nthuee822/project_meatball/images/1769949203630.jpg

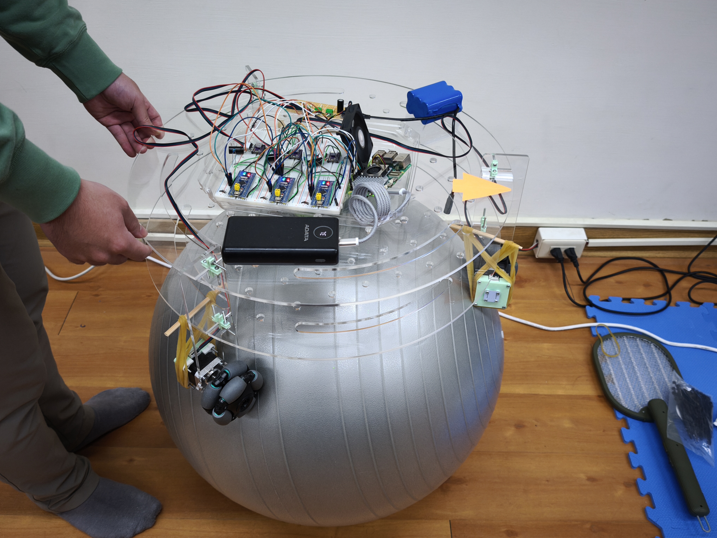
images/1769949203630.jpg
