nthuee822/project_meatball/images/154278.jpg

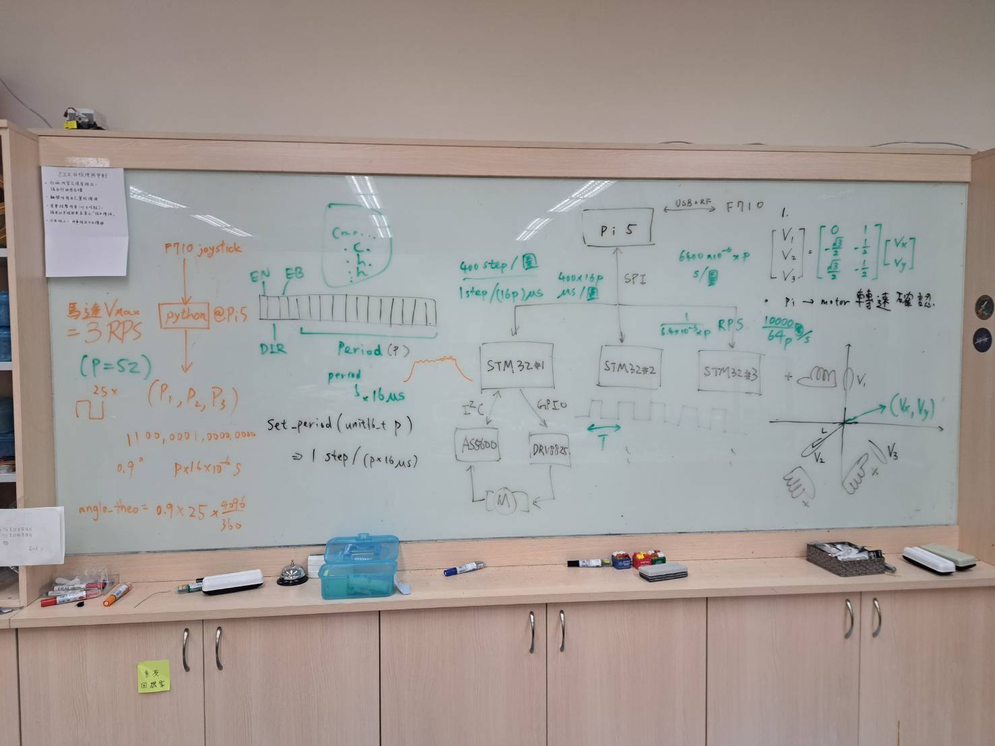
images/154278.jpg
