nthuee822/project_meatball/images/Gemini_Generated_Image_a7wogra7wogra7wo.png

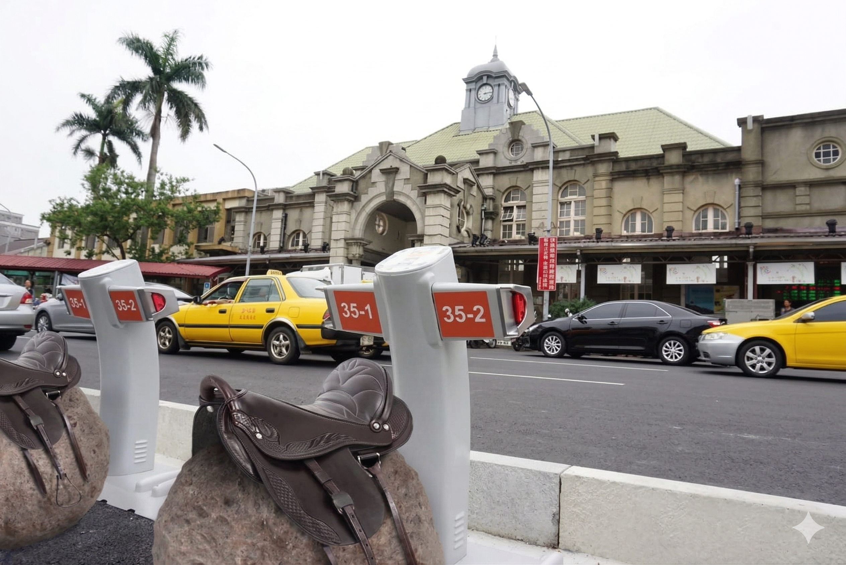
images/Gemini_Generated_Image_a7wogra7wogra7wo.png
