nthuee822/project_meatball/hardware/ht7k1401_breakout/production/bom.csv

Designator | Footprint | Quantity | Value | LCSC Part #
C1, C3, C4 | 0805 | 3 | 100n
C2 | CP_Radial_D6.3mm_P2.50mm | 1 | 100u
J1, J2 | TerminalBlock_MaiXu_MX126-5.0-02P_1x02_P5.00mm | 2 | Conn_01x02_Socket
J3 | PinHeader_1x05_P2.54mm_Vertical | 1 | Conn_01x05_Pin
R1 | 2512_shunt | 1 | 200m
R2, R3 | 0805 | 2 | 10k
R4, R5, R6, R7 | 0805 | 4 | 30k
TP1, TP2 | TestPoint_THTPad_D1.5mm_Drill0.7mm | 2 | TestPoint
U1 | HSOP-8-1EP_3.9x4.9mm_P1.27mm_EP2.41x3.1mm | 1 | HT7K1401
U2 | SOIC-8_3.9x4.9mm_P1.27mm | 1 | OPAMP
