nthuee822/project_meatball/3d_model/magnet_mold-Body.3mf

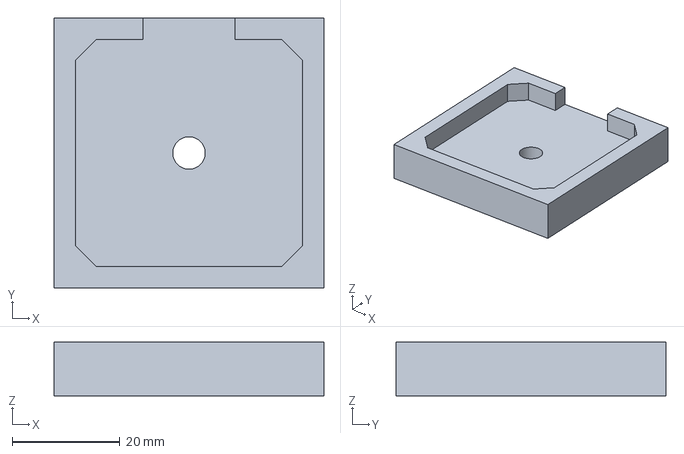
[picture p4: CAD file, 2026-07-13]
3d_model/magnet_mold-Body.3mf
50.0 x 50.0 x 10.0 mm
