nthuee822/project_meatball/3d_model/motor_holder-Body.3mf

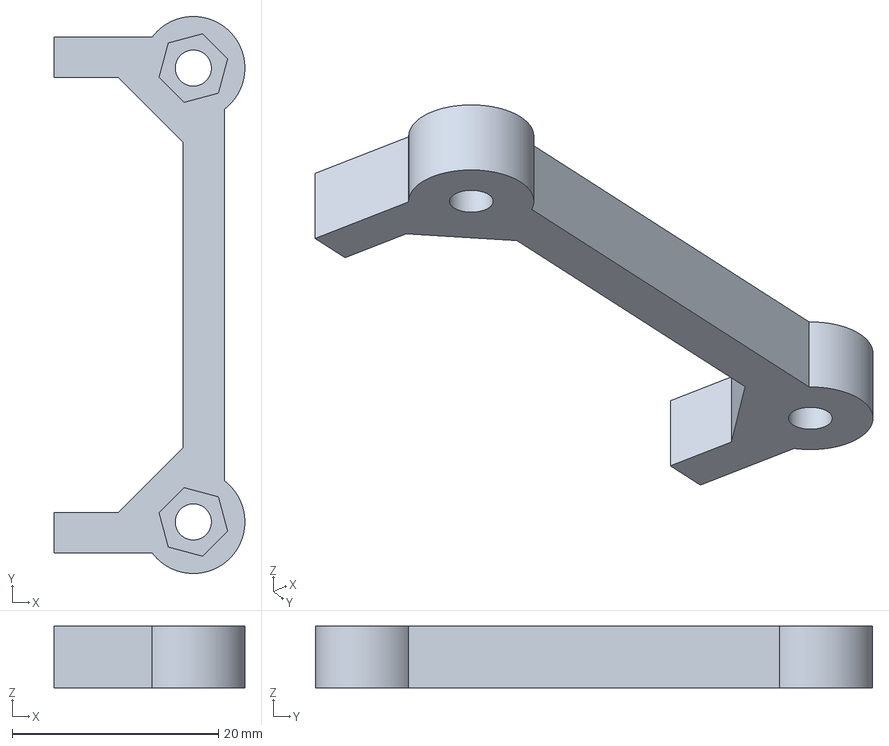
[picture p5: CAD file, 2026-07-13]
3d_model/motor_holder-Body.3mf
18.5 x 54.0 x 6.00 mm
