nthuee822/project_meatball/3d_model/hall_sensor_holder_v2-Body.3mf

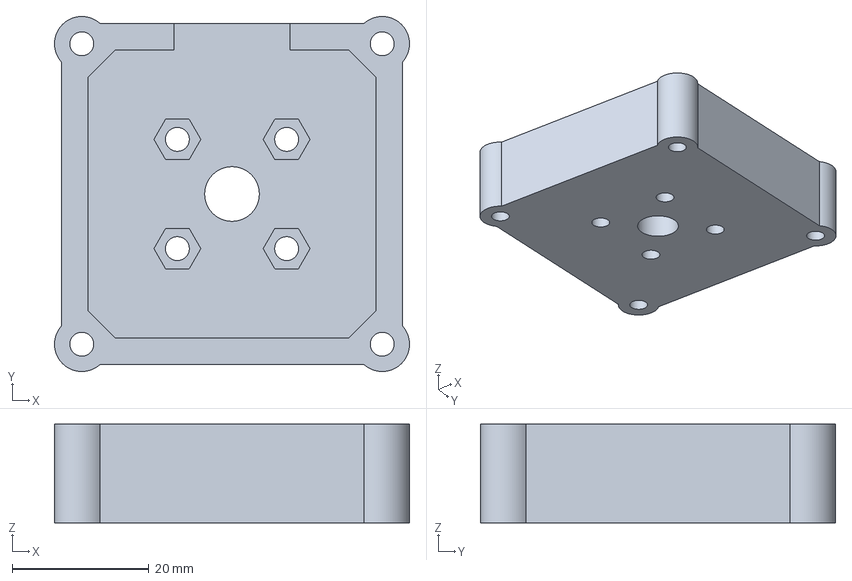
[picture p6: CAD file, 2026-07-13]
3d_model/hall_sensor_holder_v2-Body.3mf
52.0 x 52.0 x 14.5 mm
