nthuee822/project_meatball/3d_model/corner-Body.3mf

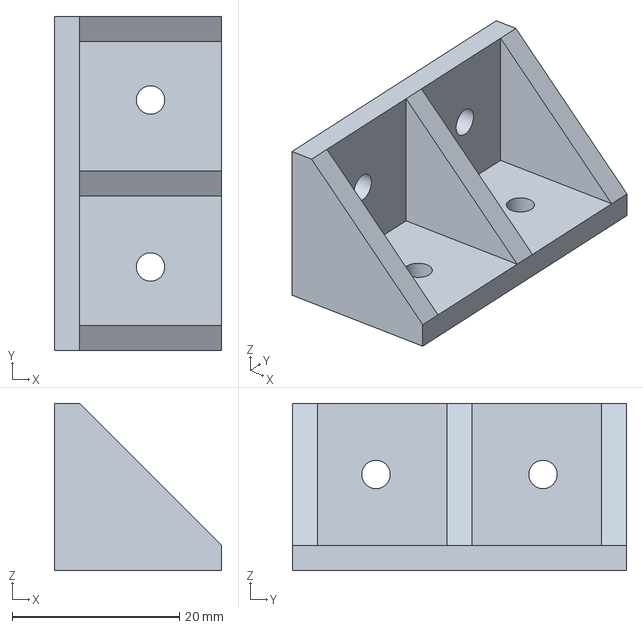
[picture p7: CAD file, 2026-07-13]
3d_model/corner-Body.3mf
20.0 x 40.0 x 20.0 mm
