nthuee822/project_meatball/3d_model/hall_sensor_holder.FCStd

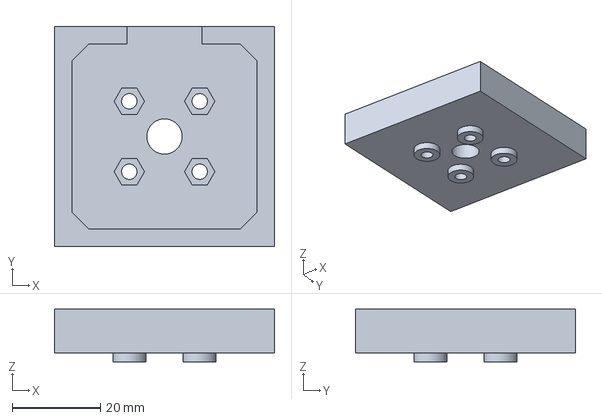
[picture p8: CAD file, 2026-07-13]
3d_model/hall_sensor_holder.FCStd
50.0 x 50.0 x 12.0 mm
