nthuee822/project_meatball/3d_model/hall_sensor_washer-Body.3mf

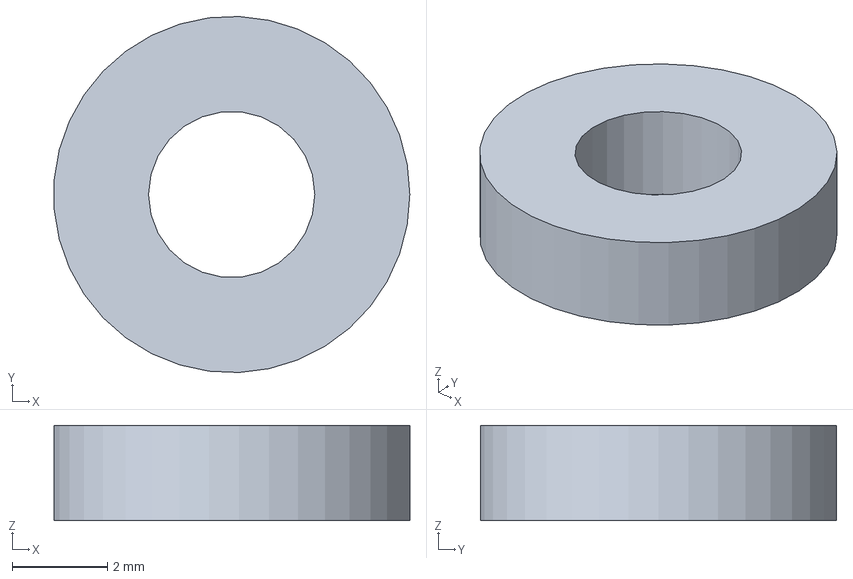
[picture p9: CAD file, 2026-07-13]
3d_model/hall_sensor_washer-Body.3mf
7.49 x 7.49 x 2.00 mm
