nthuee822/project_meatball/(list of files, cad)

Other CAD files:
3d_model/magnet_mold.FCStd
3d_model/motor_holder.FCStd
3d_model/hall_sensor_holder_v2.FCStd
3d_model/corner.FCStd
3d_model/hall_sensor_holder-Body.3mf
3d_model/magnet_mold-Body-55.3mf
3d_model/hall_sensor_washer.FCStd
