nthuee822/project_meatball/stm32/adc_alignment_test/default.csv

Time (s) | Channel 1 (V) | Channel 2 (V)
0.1490640601173546 | 3.328230990314466 | 2.371660884159364
0.1490641901173546 | 3.329122501781653 | 2.375237606756229
0.1490643201173546 | 3.326447967379739 | 2.376131787405312
0.1490644501173546 | 3.323773432977882 | 2.380602690651547
0.1490645801173546 | 3.327339478847092 | 2.384179413247884
0.1490647101173546 | 3.324664944445176 | 2.388650316493303
0.1490648401173546 | 3.326447967379747 | 2.381496871300358
0.1490649701173546 | 3.329122501781663 | 2.381496871300358
0.1490651001173546 | 3.325556455912392 | 2.385073593897048
0.1490652301173546 | 3.328230990314308 | 2.385073593897048
0.1490653601173546 | 3.330014013249154 | 2.3752376067564
0.1490654901173546 | 3.32733947884724 | 2.380602690650898
0.1490656201173546 | 3.330014013248898 | 2.382391051949313
0.1490657501173546 | 3.32377343297776 | 2.378814329352978
0.1490658801173546 | 3.325556455912847 | 2.384179413248078
0.1490660101173546 | 3.332688547651291 | 2.38686195519533
0.1490661401173546 | 3.318424364173881 | 2.378814329353002
0.1490662701173546 | 3.32644796737963 | 2.380602690651169
0.1490664001173546 | 3.327339478846815 | 2.383285232598137
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
