nthuee822/project_meatball/stm32/adc_alignment_test/adc_plot.png

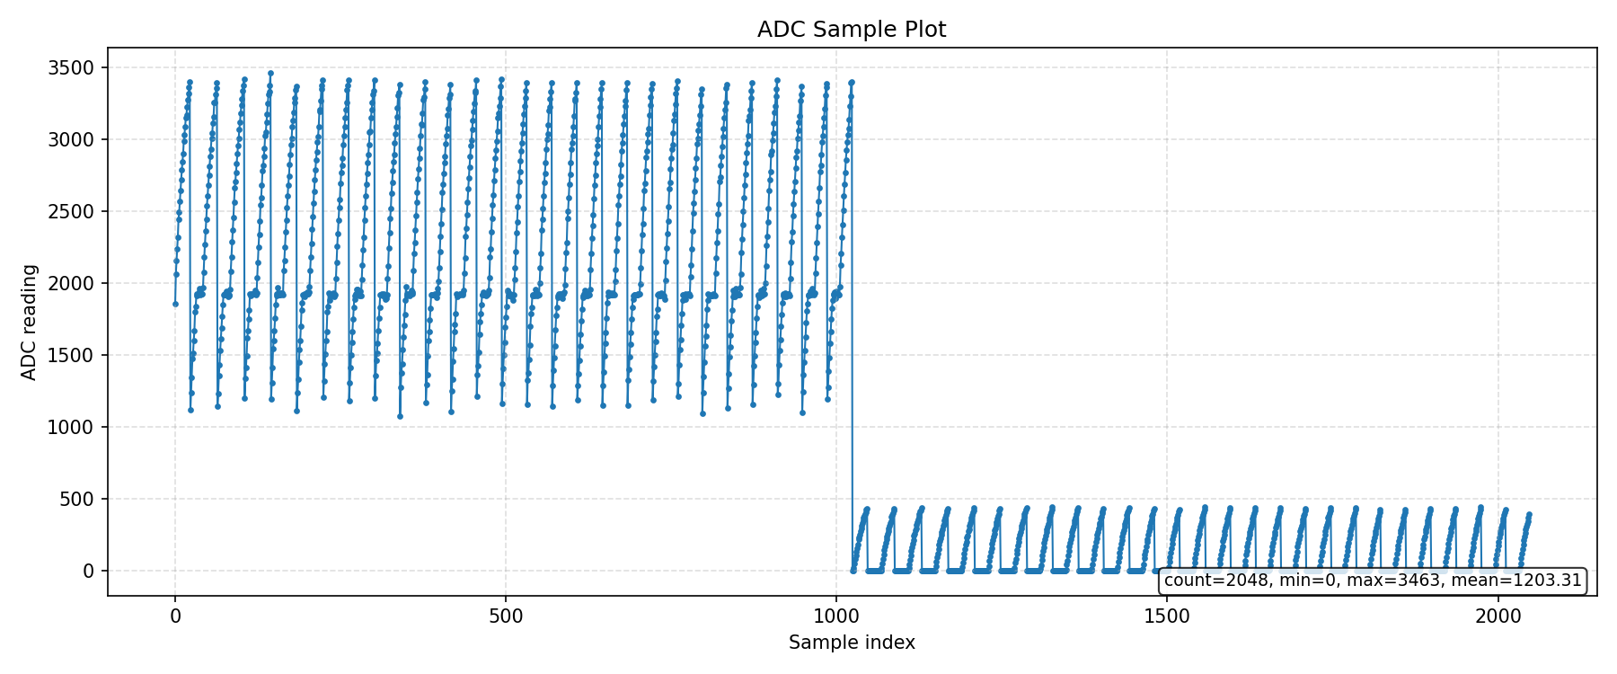
stm32/adc_alignment_test/adc_plot.png
