nthuee822/project_meatball/stm32/adc_alignment_test/adc_plot_original.png

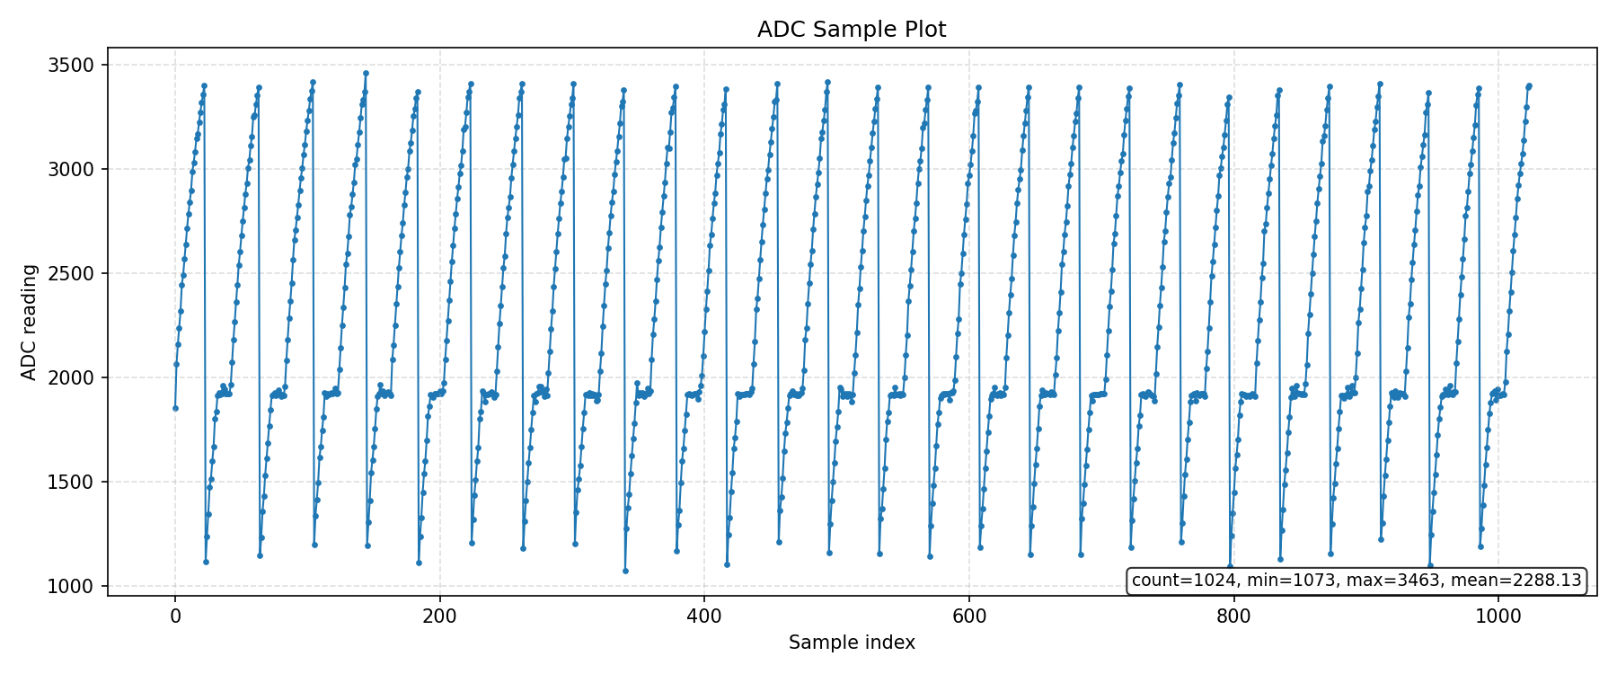
stm32/adc_alignment_test/adc_plot_original.png
