nthuee822/project_meatball/architecture/architecture.pdf

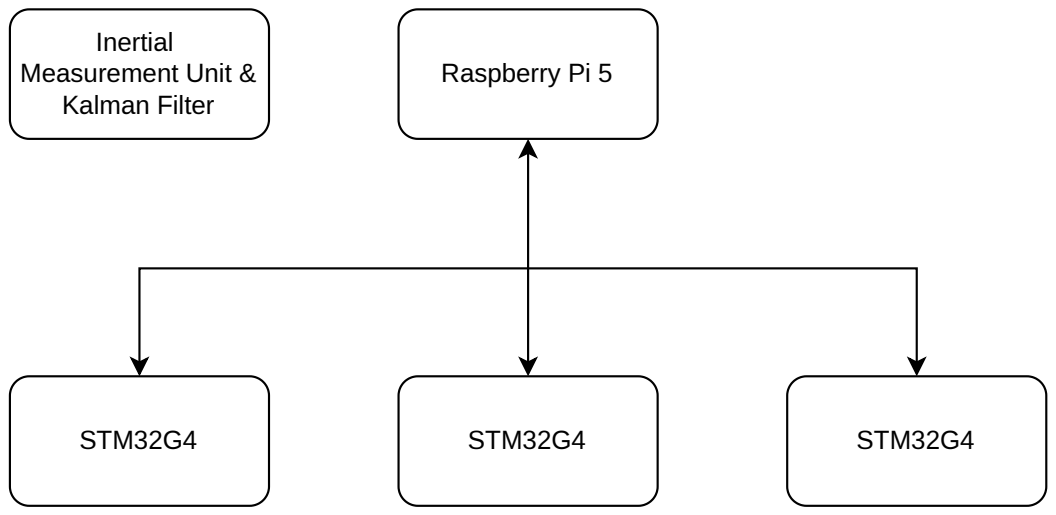
[picture p12: page 1]
Raspberry Pi 5; STM32G4; Inertial Measurement Unit & Kalman Filter
