nthuee822/project_meatball/architecture/architecture_v1.pdf

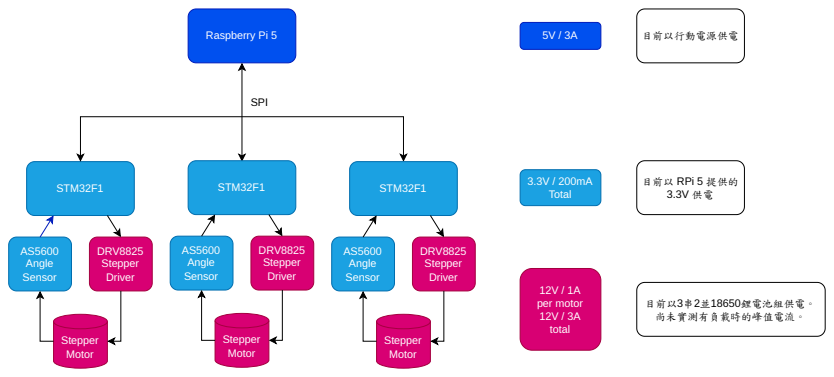
[picture p13: page 1]
Raspberry Pi 5; STM32F1; DRV8825 Stepper Driver; AS5600 Angle Sensor; Stepper Motor; SPI; 3.3V / 200mA Total; 12V / 1A per motor 12V / 3A total; 目前以行動電源供電; 目前以3串2並18650鋰電池組供電。 尚未實測有負載時的峰值電流。

目前以 RPi 5 提供的
