nthuee822/project_meatball/hardware/ht7k1401_breakout/ht7k1401_breakout.pdf

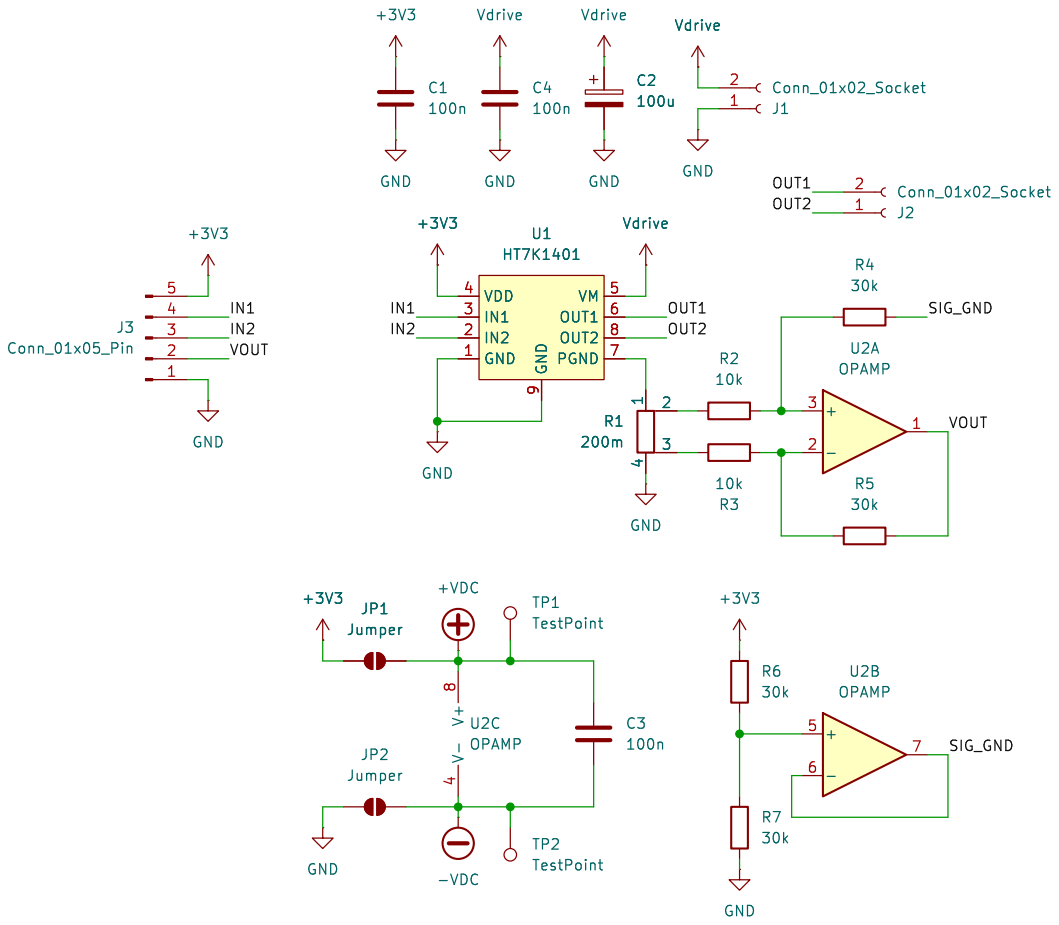
[picture p14: page 1]

9 VM 5 OUT1 6 OUT2 8 PGND 7 U1 HT7K1401 Vdrive Vdrive C2

Id: 1/1 Title: File: ht7k1401_breakout.kicad_sch Sheet: /
