nthuee822/project_meatball/hardware/ht7k1401_breakout/ht7k1401_breakout.kicad_pcb

## KiCad design hardware/ht7k1401_breakout/ht7k1401_breakout.kicad_pcb (2026-07-13)

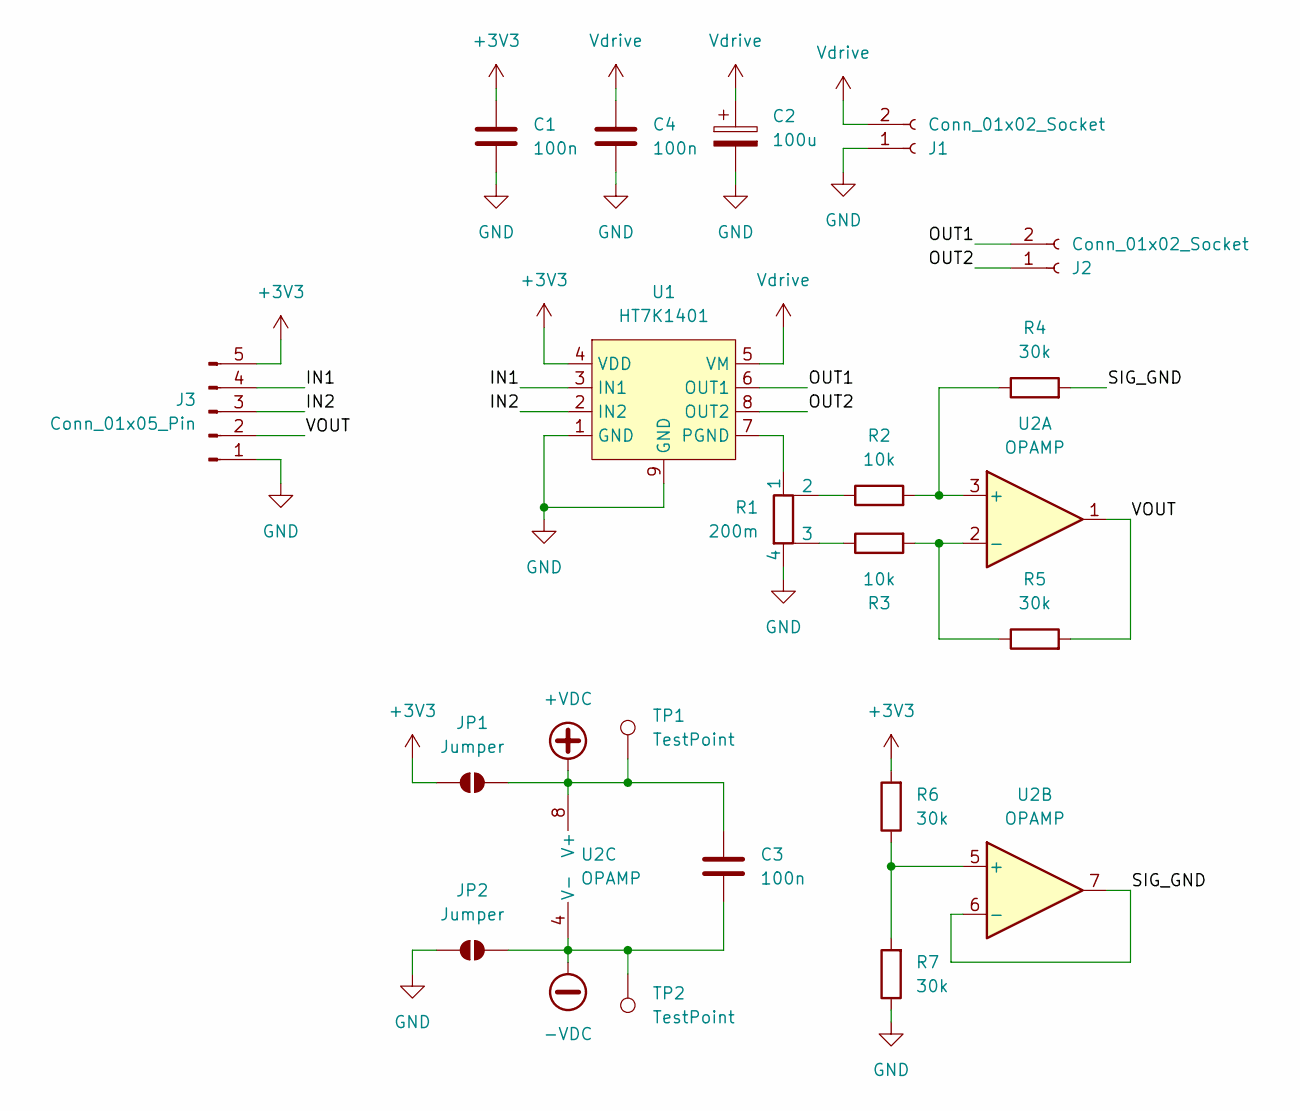
[picture p15: schematic ht7k1401_breakout.kicad_sch]

Parts:
C1, C3, C4: 100n; C_0805_2012Metric_Pad1.18x1.45mm_HandSolder
C2: 100u; CP_Radial_D6.3mm_P2.50mm
J1, J2: Conn_01x02_Socket; TerminalBlock_MaiXu_MX126-5.0-02P_1x02_P5.00mm
J3: Conn_01x05_Pin; PinHeader_1x05_P2.54mm_Vertical
JP1, JP2: Jumper; SolderJumper-2_P1.3mm_Open_RoundedPad1.0x1.5mm
R1: 200m; 2512_shunt
R2, R3: 10k; R_0805_2012Metric_Pad1.20x1.40mm_HandSolder
R4, R5, R6, R7: 30k; R_0805_2012Metric_Pad1.20x1.40mm_HandSolder
TP1, TP2: TestPoint; TestPoint_THTPad_D1.5mm_Drill0.7mm
U1: HT7K1401; HSOP-8-1EP_3.9x4.9mm_P1.27mm_EP2.41x3.1mm
U2: OPAMP; SOIC-8_3.9x4.9mm_P1.27mm

Connections:
+3V3: C1.1, J3.5, JP1.1 (A), R6.2, U1.4 (VDD)
+VDC: C3.1, JP1.2 (B), TP1.1, U2.8 (V+)
-VDC: C3.2, JP2.2 (B), TP2.1, U2.4 (V-)
/IN1: J3.4, U1.3 (IN1)
/IN2: J3.3, U1.2 (IN2)
/OUT1: J2.2, U1.6 (OUT1)
/OUT2: J2.1, U1.8 (OUT2)
/SIG_GND: R4.2, U2.6 (-), U2.7
/VOUT: J3.2, R5.2, U2.1
GND: C1.2, C2.2, C4.2, J1.1, J3.1, JP2.1 (A), R1.4, R7.1, U1.1 (GND), U1.9 (GND)
unnamed: R1.2, R2.1
unnamed: R1.3, R3.1
unnamed: R1.1, U1.7 (PGND)
unnamed: R2.2, R4.1, U2.3 (+)
unnamed: R3.2, R5.1, U2.2 (-)
unnamed: R6.1, R7.2, U2.5 (+)
Vdrive: C2.1, C4.1, J1.2, U1.5 (VM)

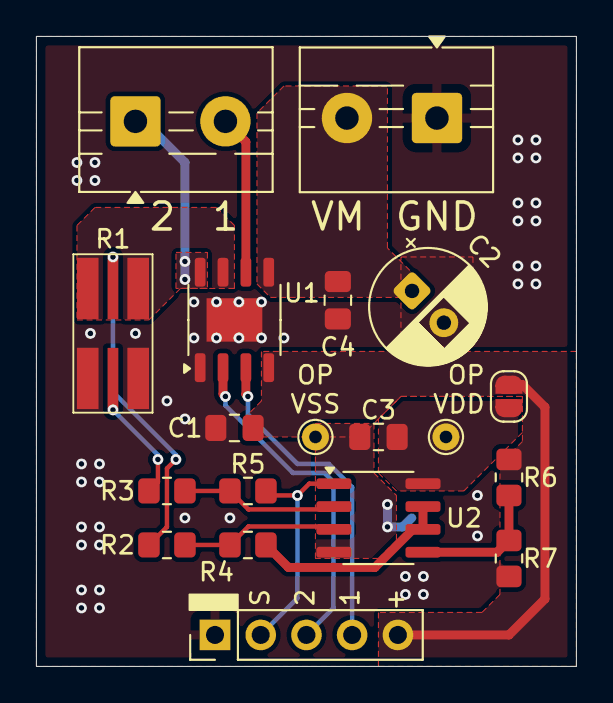
[picture p16: board ht7k1401_breakout.kicad_pcb from above]

Board: 2 copper layers, 30.0 x 35.0 mm, 20 parts (1 on the bottom side), 17 nets.
