nthuee822/project_meatball/stm32/foc_v1/Core/Src/main.c

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
/* Includes ------------------------------------------------------------------*/
#include "main.h"

/* USER CODE BEGIN Includes */
#include "as5600.h"
#include "kalman.h"
#include "stm32g4xx_hal_exti.h"
#include "stm32g4xx_hal_gpio.h"
#include "stm32g4xx_hal_tim.h"
#include <stdint.h>
#include "stm32-cordic.h"
/* USER CODE END Includes */

ADC_HandleTypeDef hadc1;
ADC_HandleTypeDef hadc2;

CORDIC_HandleTypeDef hcordic;

I2C_HandleTypeDef hi2c2;
DMA_HandleTypeDef hdma_i2c2_rx;

TIM_HandleTypeDef htim1;
TIM_HandleTypeDef htim6;
TIM_HandleTypeDef htim7;

UART_HandleTypeDef huart2;

/* USER CODE BEGIN PV */
AS5600_TypeDef *myAS5600;

volatile uint8_t timer_triggered = 0;
volatile uint8_t step_triggered = 0;
volatile uint8_t motor_enable = 0;
volatile uint8_t dma_ready = 0;

KalmanStruct KF;
KalmanStruct *kf;

uint16_t pwm_level[4][2] = {
  {75, 50},
  {50, 75},
  {25, 50},
  {50, 25}
};
/* USER CODE END PV */

void SystemClock_Config(void);
static void MX_GPIO_Init(void);
static void MX_DMA_Init(void);
static void MX_I2C2_Init(void);
static void MX_USART2_UART_Init(void);
static void MX_CORDIC_Init(void);
static void MX_TIM7_Init(void);
static void MX_TIM6_Init(void);
static void MX_TIM1_Init(void);
static void MX_ADC1_Init(void);
static void MX_ADC2_Init(void);
/**
  * @brief  The application entry point.
  * @retval int
  */
int main(void)
{

  /* MCU Configuration--------------------------------------------------------*/

  /* Reset of all peripherals, Initializes the Flash interface and the Systick. */
  HAL_Init();

  /* Configure the system clock */
  SystemClock_Config();

  /* Initialize all configured peripherals */
  MX_GPIO_Init();
  MX_DMA_Init();
  MX_I2C2_Init();
  MX_USART2_UART_Init();
  MX_CORDIC_Init();
  MX_TIM7_Init();
  MX_TIM6_Init();
  MX_TIM1_Init();
  MX_ADC1_Init();
  MX_ADC2_Init();
  /* USER CODE BEGIN 2 */
  // AS5600 setup
  myAS5600 = AS5600_New();
  myAS5600->i2cAddr = (0x36 << 1);  // 7-bit address shifted for HAL
  myAS5600->i2cHandle = &hi2c2;
  myAS5600->SlowFilter = AS5600_SLOW_FILTER_2X;
  myAS5600->FastFilterThreshold = AS5600_FAST_FILTER_6LSB;
  AS5600_Init(myAS5600);

  // Kalman filter setup
  kf = &KF;
  kf->dt = 50e-6f;
  kf->x[0] = 0.f;
  kf->x[1] = 0.f;
  kf->P[0][0] = 10.f;
  kf->P[0][1] = 0.f;
  kf->P[1][0] = 0.f;
  kf->P[1][1] = 10.f;
  kf->Q[0][0] = 0.01f;
  kf->Q[0][1] = 0.f;
  kf->Q[1][0] = 0.f;
  kf->Q[1][1] = 1e5f;
  kf->R = 0.24f;

  // timer setup
  HAL_TIM_Base_Start_IT(&htim6);
  HAL_TIM_Base_Start_IT(&htim7);
  /* USER CODE END 2 */

  /* Infinite loop */
  /* USER CODE BEGIN WHILE */
  int level_index = 0;
  while (1)
  {
    /* USER CODE END WHILE */

    /* USER CODE BEGIN 3 */
    if(step_triggered) {
      if(level_index >= 3) {
        level_index = 0;
      } else {
        level_index++;
      }

      step_triggered = 0;   // clear flag
    }

    if(timer_triggered) {
      if(motor_enable) {
        HAL_TIM_PWM_Start(&htim1, TIM_CHANNEL_2);
        HAL_TIMEx_PWMN_Start(&htim1, TIM_CHANNEL_2);
        HAL_TIM_PWM_Start(&htim1, TIM_CHANNEL_3);
        HAL_TIMEx_PWMN_Start(&htim1, TIM_CHANNEL_3);

        __HAL_TIM_SET_COMPARE(&htim1, TIM_CHANNEL_2, pwm_level[level_index][0]);  // A
        __HAL_TIM_SET_COMPARE(&htim1, TIM_CHANNEL_3, pwm_level[level_index][1]);  // B
      } else {
        HAL_TIM_PWM_Stop(&htim1, TIM_CHANNEL_2);
        HAL_TIMEx_PWMN_Stop(&htim1, TIM_CHANNEL_2);
        HAL_TIM_PWM_Stop(&htim1, TIM_CHANNEL_3);
        HAL_TIMEx_PWMN_Stop(&htim1, TIM_CHANNEL_3);
      }

      timer_triggered = 0;    // clear flag
    }
  }
  /* USER CODE END 3 */
}

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
/* USER CODE BEGIN 4 */
void HAL_TIM_PeriodElapsedCallback(TIM_HandleTypeDef *htim) {
  if(htim == &htim7) {
    timer_triggered = 1;
  }

  if (htim == &htim6) {
    step_triggered = 1;
  }
}

void HAL_GPIO_EXTI_Callback(uint16_t GPIO_Pin) {
  if(GPIO_Pin == GPIO_PIN_13) {
    motor_enable = !motor_enable;
  }
}
/* USER CODE END 4 */
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
