nthuee822/project_meatball/stm32/foc_v1/foc_v1.ioc

Mcu.UserName=STM32G431RBTx
PA0.Signal=ADC1_IN1
PA1.Signal=ADC2_IN2
PA13.GPIO_Label=T_SWDIO
PA13.Signal=SYS_JTMS-SWDIO
PA14.GPIO_Label=T_SWCLK
PA14.Signal=SYS_JTCK-SWCLK
PA2.Signal=USART2_TX
PA3.Signal=USART2_RX
PA8.Signal=I2C2_SDA
PA9.Signal=I2C2_SCL
PB0.Signal=TIM1_CH2N
PB1.Signal=TIM1_CH3N
PC1.Signal=S_TIM1_CH2
PC13.Signal=GPXTI13
PC2.Signal=S_TIM1_CH3
PF0-OSC_IN.GPIO_Label=RCC_OSC_IN
PF0-OSC_IN.Signal=RCC_OSC_IN
PF1-OSC_OUT.GPIO_Label=RCC_OSC_OUT
PF1-OSC_OUT.Signal=RCC_OSC_OUT
