nthuee822/project_meatball/stm32/motor/Core/Src/main.c

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
/* Includes ------------------------------------------------------------------*/
#include "main.h"

/* USER CODE BEGIN Includes */
#include "stm32_hal_legacy.h"
#include "stm32f103xb.h"
#include "stm32f1xx_hal_tim.h"
#include "stm32f1xx_hal.h"
#include "stm32f1xx_hal_def.h"
#include "stm32f1xx_hal_gpio.h"
#include "stdlib.h"
#include "as5600.h"
/* USER CODE END Includes */

/* USER CODE BEGIN PD */
#define DRV8825_1_STEP 0x00
#define DRV8825_2_STEP 0x01
#define DRV8825_4_STEP 0x02
#define DRV8825_8_STEP 0x03
#define DRV8825_16_STEP 0x04
#define DRV8825_32_STEP 0x05

#define MIN_PERIOD 64 // Minimum period for the step signal
/* USER CODE END PD */

I2C_HandleTypeDef hi2c1;

SPI_HandleTypeDef hspi1;

TIM_HandleTypeDef htim3;

UART_HandleTypeDef huart2;

void SystemClock_Config(void);
static void MX_GPIO_Init(void);
static void MX_I2C1_Init(void);
static void MX_SPI1_Init(void);
static void MX_TIM3_Init(void);
static void MX_USART2_UART_Init(void);
/* USER CODE BEGIN 0 */
void set_period(uint16_t period) {  // Sets the period for the step signal
  // TIM_OC_InitTypeDef sConfigOC;

  // sConfigOC.OCMode = TIM_OCMODE_TOGGLE;
  // sConfigOC.Pulse = period;
  // sConfigOC.OCPolarity = TIM_OCPOLARITY_HIGH;
  // sConfigOC.OCFastMode = TIM_OCFAST_DISABLE;

  // if (HAL_TIM_OC_ConfigChannel(&htim3, &sConfigOC, TIM_CHANNEL_3) != HAL_OK)
  // {
  //   Error_Handler();
  // }

  if (period < MIN_PERIOD) period = MIN_PERIOD;
  __HAL_TIM_SET_COMPARE(&htim3, TIM_CHANNEL_3, period);
  __HAL_TIM_SET_AUTORELOAD(&htim3, period);
}

void set_microstep(uint8_t microstep) { // Sets the microstepping mode
  switch(microstep) {
    case DRV8825_1_STEP:
      HAL_GPIO_WritePin(GPIOB, GPIO_PIN_13, GPIO_PIN_RESET);
      HAL_GPIO_WritePin(GPIOB, GPIO_PIN_14, GPIO_PIN_RESET);
      HAL_GPIO_WritePin(GPIOB, GPIO_PIN_15, GPIO_PIN_RESET);
      break;
    case DRV8825_2_STEP:
      HAL_GPIO_WritePin(GPIOB, GPIO_PIN_13, GPIO_PIN_SET);
      HAL_GPIO_WritePin(GPIOB, GPIO_PIN_14, GPIO_PIN_RESET);
      HAL_GPIO_WritePin(GPIOB, GPIO_PIN_15, GPIO_PIN_RESET);
      break;
    case DRV8825_4_STEP:
      HAL_GPIO_WritePin(GPIOB, GPIO_PIN_13, GPIO_PIN_RESET);
      HAL_GPIO_WritePin(GPIOB, GPIO_PIN_14, GPIO_PIN_SET);
      HAL_GPIO_WritePin(GPIOB, GPIO_PIN_15, GPIO_PIN_RESET);
      break;
    case DRV8825_8_STEP:
      HAL_GPIO_WritePin(GPIOB, GPIO_PIN_13, GPIO_PIN_SET);
      HAL_GPIO_WritePin(GPIOB, GPIO_PIN_14, GPIO_PIN_SET);
      HAL_GPIO_WritePin(GPIOB, GPIO_PIN_15, GPIO_PIN_RESET);
      break;
    case DRV8825_16_STEP:
      HAL_GPIO_WritePin(GPIOB, GPIO_PIN_13, GPIO_PIN_RESET);
      HAL_GPIO_WritePin(GPIOB, GPIO_PIN_14, GPIO_PIN_RESET);
      HAL_GPIO_WritePin(GPIOB, GPIO_PIN_15, GPIO_PIN_SET);
      break;
    case DRV8825_32_STEP:
      HAL_GPIO_WritePin(GPIOB, GPIO_PIN_13, GPIO_PIN_SET);
      HAL_GPIO_WritePin(GPIOB, GPIO_PIN_14, GPIO_PIN_SET);
      HAL_GPIO_WritePin(GPIOB, GPIO_PIN_15, GPIO_PIN_SET);
      break;
    default:
      break;
  }
}

volatile uint8_t spi_rx_complete_flag = 0;
volatile uint16_t received_frame;
volatile uint16_t period;

void HAL_SPI_RxCpltCallback(SPI_HandleTypeDef *hspi) {

  uint8_t enable = (received_frame & 0x8000) != 0; // check MSB
  uint8_t direction = (received_frame & 0x4000) != 0; // check bit 14
  uint16_t raw_period = received_frame & 0x0FFF; // last 12 bits

  uint8_t microstep;
  if(raw_period < MIN_PERIOD) {
    microstep = DRV8825_1_STEP;
    period = MIN_PERIOD;
  } else if(raw_period >= 128) {
    microstep = DRV8825_4_STEP;
    period = raw_period / 4;
  } else {
    microstep = DRV8825_1_STEP;
    period = raw_period;
  }

  set_microstep(microstep);
  set_period(period);
  HAL_GPIO_WritePin(GPIOB, GPIO_PIN_1, !enable); // enable is low active on PB1
  HAL_GPIO_WritePin(GPIOB, GPIO_PIN_10, direction); // direction on PB2

  // uint8_t Test[] = "SPI\n"; //Data to send
  // char Test[20];
  // sprintf(Test, "SPI: 0x%04X\r\n", received_frame);
  // HAL_UART_Transmit(&huart2, (uint8_t*)Test, sizeof(Test), 10);// Sending in normal mode
  // if(enable) HAL_UART_Transmit(&huart2, (uint8_t*)"e\r\n", 3, 10);

  HAL_SPI_Receive_IT(&hspi1, (uint8_t*)&received_frame, 2); // Restart SPI reception
}

AS5600_TypeDef *a;

volatile uint8_t period_cnt = 0;
volatile uint8_t angle_sample_flag = 0;
volatile uint16_t last_valid_angle = 0;

float theoretical_angle_float = 0;
uint16_t angle_theo = 0;

void HAL_TIM_PeriodElapsedCallback(TIM_HandleTypeDef *htim)
{
    if (htim->Instance == htim3.Instance) {
      theoretical_angle_float += 20.48f;
      
      if (theoretical_angle_float >= 4096.0f) {
        theoretical_angle_float -= 4096.0f;
      }

      angle_theo = (uint16_t)theoretical_angle_float;
      period_cnt++;

      if (period_cnt >= 50) {
        period_cnt = 0;
        angle_sample_flag = 1;
      }
    }
}

uint16_t get_angle(void) {
  uint16_t current_angle = 0;

  if (angle_sample_flag == 1) {
    if (AS5600_GetAngle(a, &current_angle) == HAL_OK) {
      last_valid_angle = current_angle;
      HAL_GPIO_WritePin(GPIOB, GPIO_PIN_11, GPIO_PIN_SET);
    }
    
    HAL_GPIO_WritePin(GPIOB, GPIO_PIN_11, GPIO_PIN_RESET);
    angle_sample_flag = 0;
  }

  return last_valid_angle;
}
/* USER CODE END 0 */

/**
  * @brief  The application entry point.
  * @retval int
  */
int main(void)
{

  /* MCU Configuration--------------------------------------------------------*/

  /* Reset of all peripherals, Initializes the Flash interface and the Systick. */
  HAL_Init();

  /* Configure the system clock */
  SystemClock_Config();

  /* Initialize all configured peripherals */
  MX_GPIO_Init();
  MX_I2C1_Init();
  MX_SPI1_Init();
  MX_TIM3_Init();
  MX_USART2_UART_Init();
  /* USER CODE BEGIN 2 */
  __HAL_TIM_GET_COUNTER(&htim3);
  HAL_TIM_Base_Start_IT(&htim3);
  HAL_TIM_OC_Start(&htim3, TIM_CHANNEL_3);
  // HAL_GPIO_WritePin(GPIOB, GPIO_PIN_1, 1);
  HAL_SPI_Receive_IT(&hspi1, (uint8_t*)&received_frame, 2);

  a = AS5600_New();
  a->i2cAddr = (0x36 << 1); // 7-bit address shifted for HAL
  a->i2cHandle = &hi2c1;
  a->DirPort = GPIOB;
  a->DirPin = GPIO_PIN_5;
  a->PositiveRotationDirection = 0;
  /* USER CODE END 2 */

  /* Infinite loop */
  /* USER CODE BEGIN WHILE */
  while (1)
  {
    uint16_t angle_meas = get_angle();
    int16_t error = (int16_t)angle_meas - (int16_t)angle_theo;

    if (error > 50) {
      if (period < 2000) period++;
        set_period(period);
    }

    else if (error < -50) {
      if (period > MIN_PERIOD) period--;
        set_period(period);
    }

    HAL_Delay(50);
    /* USER CODE END WHILE */

    /* USER CODE BEGIN 3 */
  }
  /* USER CODE END 3 */
}

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
