nthuee822/project_meatball/stm32/common_lib/as5600.h

/*************************************************************************
Title:    as5600.h - Driver for AMS AS5600 12-Bit Programmable Contactless
                                         Potentiometer
Author:   Nicholas Morrow <nickhudspeth@gmail.com>
File:     as5600.h
Software: STM32Fxxx_HAL_Driver, CMSIS-CORE
Hardware: STM32Fxxx
License:  The MIT License (MIT)

DESCRIPTION:


USAGE:
        // Instantiate an AS5600 structure
        AS5600_TypeDef *a = AS5600_New();

    // Configure non-default options, if required.
    a->PositiveRotationDirection = AS5600_DIR_CCW;
        a->LowPowerMode = AS5600_POWER_MODE_LPM2;
    a->OutputStage = AS5600_OUTPUT_STAGE_PWM;
    a->PWMFrequency = AS5600_PWM_FREQUENCY_460HZ;
    a->Watchdog = AS5600_WATCHDOG_OFF;

    // Initialize AS5600 with selected options and check for initialization
errors.
    if(AS5600_Init(a) != HAL_OK){
        _Error_Handler(__FILE__, __LINE__);
    }

    // Read angular measurements
    uint16_t angle = 0;
    while(1){
        AS5600_GetAngle(a, &angle);
        printf("Angle = %ld degrees.\n", angle);
    }

NOTES:
    Driver does not currently support permanent writing of registers using OTP
burn commands.
    Driver does not currently support angle measurement using ADC.
    Driver does not currently support angle measurement using AS5600 in PWM
output mode.

TO-DO:


LICENSE:
    Copyright (C) 2018 Pathogen Systems, Inc. dba Crystal Diagnostics

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
*************************************************************************/
#ifndef AS5600_H_
#define AS5600_H_
/**********************    INCLUDE DIRECTIVES    ***********************/
#include <stdint.h>
#include "stm32g4xx_hal.h"

/**************    CONSTANTS, MACROS, & DATA STRUCTURES    ***************/
#define AS5600_SLAVE_ADDRESS 0x36
/* AS5600 Configuration Registers */
#define AS5600_REGISTER_ZMCO 0x00
#define AS5600_REGISTER_ZPOS_HIGH 0x01
#define AS5600_REGISTER_ZPOS_LOW 0x02
#define AS5600_REGISTER_MPOS_HIGH 0x03
#define AS5600_REGISTER_MPOS_LOW 0x04
#define AS5600_REGISTER_MANG_HIGH 0x05
#define AS5600_REGISTER_MANG_LOW 0x06
#define AS5600_REGISTER_CONF_HIGH 0x07
#define AS5600_REGISTER_CONF_LOW 0x08
/* AS5600 Output Registers */
#define AS5600_REGISTER_RAW_ANGLE_HIGH 0x0C
#define AS5600_REGISTER_RAW_ANGLE_LOW 0x0D
#define AS5600_REGISTER_ANGLE_HIGH 0x0E
#define AS5600_REGISTER_ANGLE_LOW 0x0F
/* AS5600 Status Registers */
#define AS5600_REGISTER_STATUS 0x0B
#define AS5600_REGISTER_AGC 0x1A
#define AS5600_REGISTER_MAGNITUDE_HIGH 0x1B
#define AS5600_REGISTER_MAGNITUDE_LOW 0x1C
#define AS5600_REGISTER_BURN 0xFF
/* AS5600 Configuration Settings */
#define AS5600_POWER_MODE_NOM 1
#define AS5600_POWER_MODE_LPM1 2
#define AS5600_POWER_MODE_LPM2 3
#define AS5600_POWER_MODE_LPM3 4
#define AS5600_POWER_MODE_DEFAULT AS5600_POWER_MODE_NOM
#define AS5600_HYSTERESIS_OFF 1
#define AS5600_HYSTERESIS_1LSB 2
#define AS5600_HYSTERESIS_2LSB 3
#define AS5600_HYSTERESIS_3LSB 4
#define AS5600_HYSTERESIS_DEFAULT AS5600_HYSTERESIS_OFF
#define AS5600_OUTPUT_STAGE_FULL                                               \
    1 /* Ratiometric analog output ranging from GND-VCC*/
#define AS5600_OUTPUT_STAGE_REDUCED                                            \
    2 /* Ratiometric analog output ranging from 10% to 90% of VCC */
#define AS5600_OUTPUT_STAGE_PWM 3 /* Digital PWM output */
#define AS5600_OUTPUT_STAGE_DEFAULT AS5600_OUTPUT_STAGE_FULL
#define AS5600_PWM_FREQUENCY_115HZ 1
#define AS5600_PWM_FREQUENCY_230HZ 2
#define AS5600_PWM_FREQUENCY_460HZ 3
#define AS5600_PWM_FREQUENCY_920HZ 4
#define AS5600_PWM_FREQUENCY_DEFAULT AS5600_PWM_FREQUENCY_115HZ
#define AS5600_SLOW_FILTER_16X 1
#define AS5600_SLOW_FILTER_8X 2
#define AS5600_SLOW_FILTER_4X 3
#define AS5600_SLOW_FILTER_2X 4
#define AS5600_SLOW_FILTER_DEFAULT AS5600_SLOW_FILTER_16X
#define AS5600_FAST_FILTER_SLOW_ONLY 1
#define AS5600_FAST_FILTER_6LSB 2
#define AS5600_FAST_FILTER_7LSB 3
#define AS5600_FAST_FILTER_9LSB 4
#define AS5600_FAST_FILTER_18LSB 5
#define AS5600_FAST_FILTER_21LSB 6
#define AS5600_FAST_FILTER_24LSB 7
#define AS5600_FAST_FILTER_10LSB 8
#define AS5600_FAST_FILTER_DEFAULT AS5600_FAST_FILTER_SLOW_ONLY
#define AS5600_WATCHDOG_OFF 1
#define AS5600_WATCHDOG_ON 2
#define AS5600_WATCHDOG_DEFAULT AS5600_WATCHDOG_ON
/* AS5600 Status Definitions */
#define AS5600_AGC_MIN_GAIN_OVERFLOW                                           \
    (uint8_t)(1UL << 3) /*Error bit indicates b-field is too string */
#define AS5600_AGC_MAX_GAIN_OVERFLOW                                           \
    (uint8_t)(1UL << 4) /*Error bit indicates b-field is too weak */
#define AS5600_MAGNET_DETECTED                                                 \
    (uint8_t)(1UL << 5) /*Status bit indicates b-field is detected */

#define AS5600_DIR_CW 1
#define AS5600_DIR_CCW 2

#define AS5600_I2C_TIMEOUT_MS 10

#define AS5600_12_BIT_MASK (uint16_t)4095
typedef struct {
    I2C_HandleTypeDef *i2cHandle;
    uint8_t i2cAddr;
    GPIO_TypeDef *DirPort;
    uint16_t DirPin;
    uint8_t PositiveRotationDirection;
    uint8_t LowPowerMode;
    uint8_t Hysteresis;
    uint8_t OutputMode;
    uint8_t PWMFrequency;
    uint8_t SlowFilter;
    uint8_t FastFilterThreshold;
    uint8_t WatchdogTimer;

    /* Private */
    volatile uint8_t confRegister[2];

} AS5600_TypeDef;

/***********************    GLOBAL VARIABLES    ***********************/
extern uint8_t as5600_dma_dest[2];

/***********************    FUNCTION PROTOTYPES    ***********************/

AS5600_TypeDef *AS5600_New(void);
HAL_StatusTypeDef AS5600_Init(AS5600_TypeDef *a);

HAL_StatusTypeDef AS5600_SetStartPosition(AS5600_TypeDef *const a,
                                          const uint16_t pos);
HAL_StatusTypeDef AS5600_SetStopPosition(AS5600_TypeDef *const a,
                                         const uint16_t pos);
HAL_StatusTypeDef AS5600_SetMaxAngle(AS5600_TypeDef *const a,
                                     const uint16_t angle);

HAL_StatusTypeDef AS5600_SetPositiveRotationDirection(AS5600_TypeDef *const a,
                                                      const uint8_t dir);

HAL_StatusTypeDef AS5600_SetLowPowerMode(AS5600_TypeDef *const a,
                                         const uint8_t mode);
HAL_StatusTypeDef AS5600_SetHysteresis(AS5600_TypeDef *const a,
                                       const uint8_t hysteresis);
HAL_StatusTypeDef AS5600_SetOutputMode(AS5600_TypeDef *const a,
                                       const uint8_t mode, uint8_t freq);
HAL_StatusTypeDef AS5600_SetSlowFilter(AS5600_TypeDef *const a,
                                       const uint8_t mode);
HAL_StatusTypeDef AS5600_SetFastFilterThreshold(AS5600_TypeDef *const a,
                                                const uint8_t threshold);
HAL_StatusTypeDef AS5600_SetWatchdogTimer(AS5600_TypeDef *const a,
                                          const uint8_t mode);

HAL_StatusTypeDef AS5600_GetAngle(AS5600_TypeDef *const a,
                                  uint16_t *const angle);
HAL_StatusTypeDef AS5600_GetAngleDMA(AS5600_TypeDef *const a);
    
HAL_StatusTypeDef AS5600_GetMagnetStatus(AS5600_TypeDef *const a,
                                         uint8_t *const stat);
HAL_StatusTypeDef AS5600_GetAGCSetting(AS5600_TypeDef *const a,
                                       uint8_t *const agc);
HAL_StatusTypeDef AS5600_GetCORDICMagnitude(AS5600_TypeDef *const a,
                                            uint16_t *const mag);

#endif /* AS5600_H_ */
