nthuee822/project_meatball/(commit log)

2026-07-13 added IMU & controller directories
2026-07-13 Added STM32 files.
    [bom.csv, current_sense_simulation.kicad_pcb, current_sense_simulation.kicad_sch, default.csv, designators.csv, ht7k1401_breakout.kicad_pcb, ht7k1401_breakout.kicad_sch, positions.csv]
2026-07-13 Added 3D models.
    [corner-Body.3mf, corner.FCStd, hall_sensor_holder-Body.3mf, hall_sensor_holder.FCStd, hall_sensor_holder_v2-Body.3mf, hall_sensor_holder_v2.FCStd, hall_sensor_washer-Body.3mf, hall_sensor_washer.FCStd]
2026-10-05 Add uv-managed Python environment
    - pyproject.toml + uv.lock: shared env at repo root; hardware libs
    (smbus2, spidev, rpi-lgpio) only install on Linux aarch64, so
    laptops can run the hardware-independent code
    - Use rpi-lgpio instead of RPi.GPIO (Pi 5 compatible, same API)
    - Add .gitignore and stop tracking __pycache__
    - Add root README and switch docs from pip install to uv
2026-10-12 Add keyboard teleop controllers and testing checklist
    - Add keyboard_controller.py (pygame window) and keyboard_teleop.py (terminal)
    as alternatives when the F710 gamepad is unavailable
    - Don't force SDL dummy video driver in f710controller
    - Raise ACCEL_RATE_UP from 0.5 to 1.0
    - Document keyboard control in controller README
    - Add TESTING.md checklist
2026-10-12 Track controller/IMU_DMP as a regular directory
    It was previously committed as a gitlink (9713eda) without .gitmodules,
    so its files were never actually stored in this repo.
